timothyjager/JBC-Soldering-Controller/README.md

# JBC-Soldering-Controller
A DIY soldering controller for JBC T245 handle &amp; C245 tips
