timothyjager/JBC-Soldering-Controller/Hardware/MainBoard/MainBoard.PcbDoc.htm

Reporting Options

# File in Previous Format

Date | : | 6/10/2017
Time | : | 3:25:28 PM
Filename | : | C:\Users\timj\Documents\Arduino\JBC-Soldering-Controller\Hardware\MainBoard\MainBoard.PcbDoc

Version | Warning

This file was generated by an earlier version of the software
