timothyjager/JBC-Soldering-Controller/Hardware/Documents/MP2456.jpg

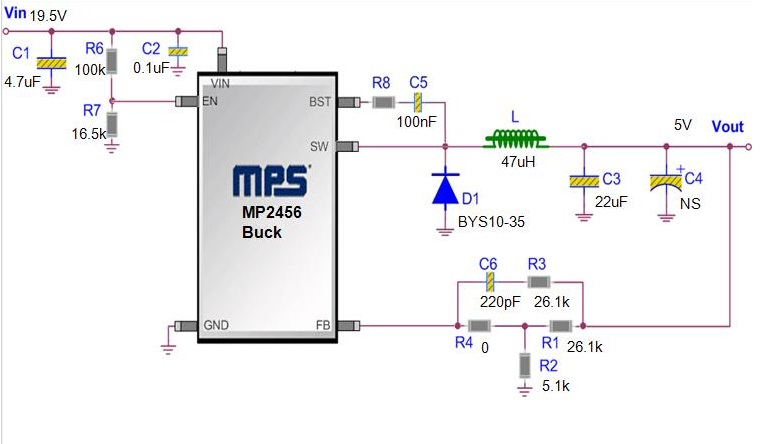
Hardware/Documents/MP2456.jpg
