timothyjager/JBC-Soldering-Controller/Hardware/Documents/MCP16301 Design Analyzer v1.0.xlsx

12
MCP16301 DESIGN ANALYZER
System Parameters | Designator |  | Units | Notes
Input Voltage | E | 24.0 | V | 3.0V < E < 30.0V
Output Voltage | U | 5.5 | V | 2.0V < U < 15.0V
Output Current | Io | 100 | mA | 0mA < Io < 600mA
Ambient Temperature | Ta | 25 | deg C | -40 < Ta < 125
 |  | Suggested Values |  | Adjustable Values
System Components | Designator |  | Units |  | Units
Minimum Required Inductance | Lmin | 17.9 | mH | 17.9 | mH
Inductance | L | 27 | mH | 27 | mH
Inductor DCR | Lr | 160 | mW | 160 | mW
Output Capacitor | C | 20 | mF | 20 | mF
Output Capacitor ESR | Cr | 5 | mW | 5 | mW
Catch Diode Forward Drop | Ufd | 0.240 | V | 0.240 | V
Compensation Components
Top Feedback Resistor | R11 | 107.0 | kW | 107.0 | kW
Bottom Feedback Resistor | R12 | 18.2 | kW | 18.2 | kW
External Zero Capacitor | C11 | 0 | pF | 0 | pF
Unity Gain Crossover Frequency |  | 21000 | Hz | 21000 | Hz
Phase Margin |  | 67.5 | Degrees | 67.5 | Degrees
