timothyjager/JBC-Soldering-Controller/Hardware/3DModels/VN50.SLDASM

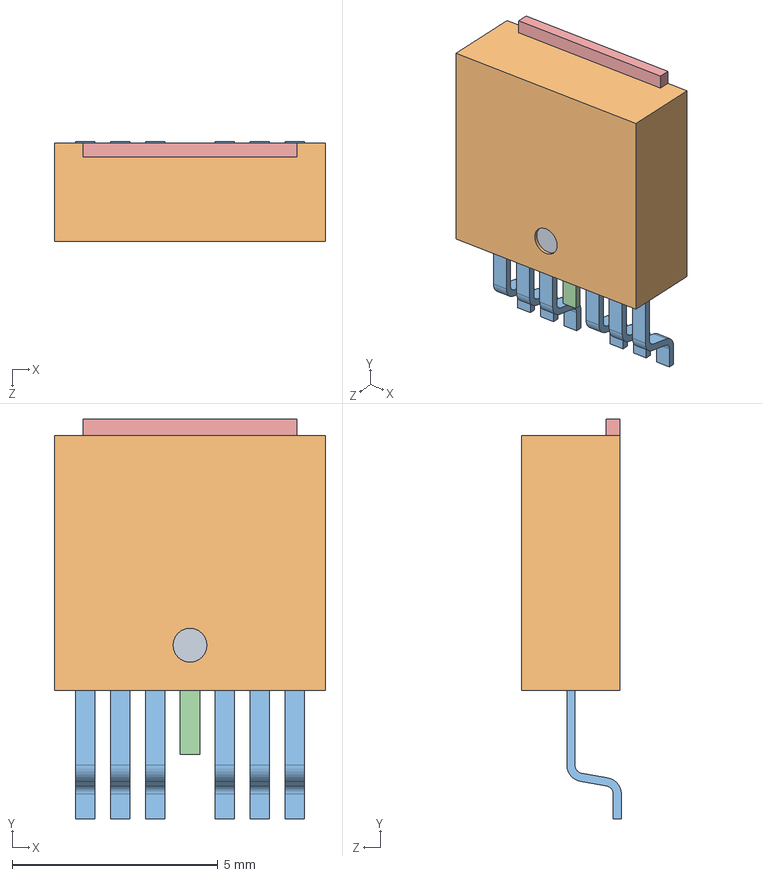
[picture p2: CAD file, 2018-01-24]
Hardware/3DModels/VN50.SLDASM
6.60 x 9.73 x 2.43 mm
Open_CASCADE_STEP_translator_6.8_5.1
Open_CASCADE_STEP_translator_6.8_5.2.1
Lead x 6
Trimmed_Lead
tab
