timothyjager/JBC-Soldering-Controller/Hardware/3DModels/ARDUINO PRO MICRO.SLDASM

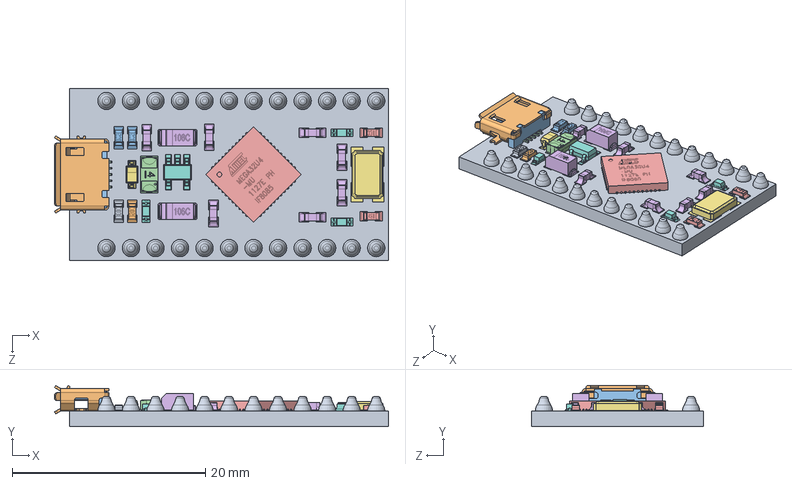
[picture p3: CAD file, 2018-01-24]
Hardware/3DModels/ARDUINO PRO MICRO.SLDASM
34.6 x 4.25 x 17.8 mm
micro board
micro usb shell
micro usb internal
micro usb contact x 5
atmega32U4
MICRO_cap106C x 2
micro_crystal 5x3
micro_MIC5219
MICRO_603 resistor 103
MICRO_603 resistor 102
MICRO_603 resistor 22 x 2
MICRO_PTC-1206
MICRO_603 resistor 331 x 2
MICRO_603 cap on pad x 7
SOD 323
MICRO_led x 3
