timothyjager/JBC-Soldering-Controller/Hardware/3DModels/SolderingController.SLDASM

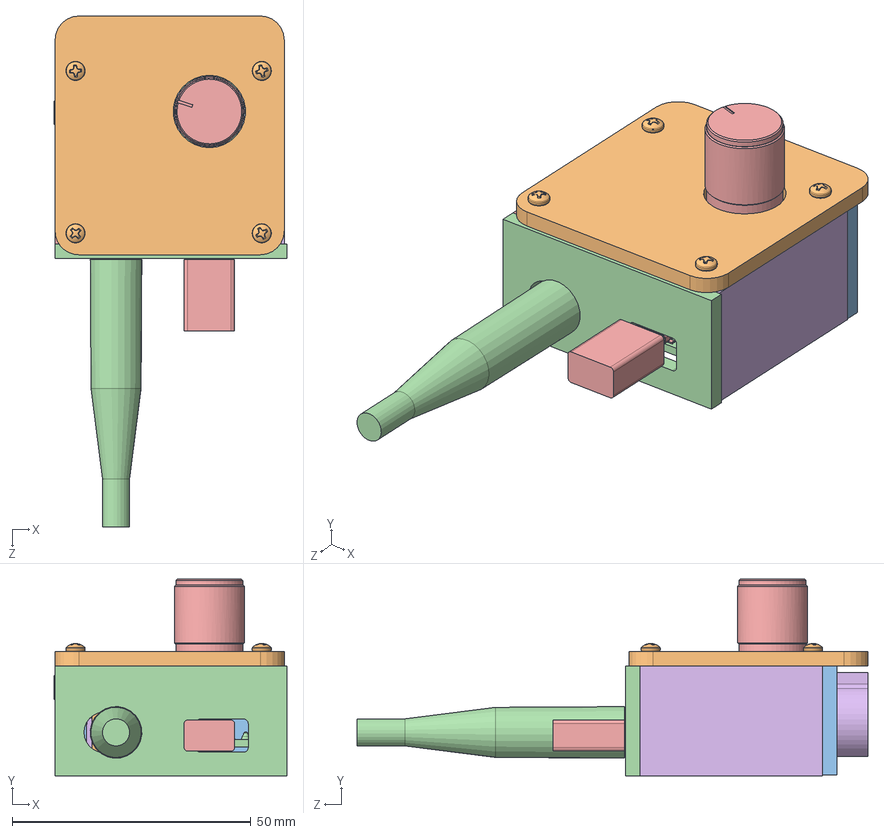
[picture p4: CAD file, 2018-01-24]
Hardware/3DModels/SolderingController.SLDASM
48.8 x 41.2 x 107.0 mm
PCB
DELL_A831M
OLED_0.91_128x32
micro board
micro usb shell
micro usb internal
micro usb contact x 5
atmega32U4
MICRO_cap106C x 2
micro_crystal 5x3
micro_MIC5219
MICRO_603 resistor 103
MICRO_603 resistor 102
MICRO_603 resistor 22 x 2
MICRO_PTC-1206
MICRO_603 resistor 331 x 2
MICRO_603 cap on pad x 7
SOD 323
MICRO_led x 3
pec11r-4x15k-sxxxx
KNOB_6mmShaft
Hirose-RPC1
OLEDFootprint
ProMicroFootprint
Open_CASCADE_STEP_translator_6.8_5.1
Open_CASCADE_STEP_translator_6.8_5.2.1
Lead x 6
Trimmed_Lead
tab
PowerPlug
MicroUSB
M2x12mmBrassStandoff x 4
M2x3x7mmBrassStandoff x 4
PJ-313D
WS2812b x 2
M2_Screw x 4
