timothyjager/JBC-Soldering-Controller/Hardware/3DModels/PowerConnector/Hirose-RPC1.SLDPRT

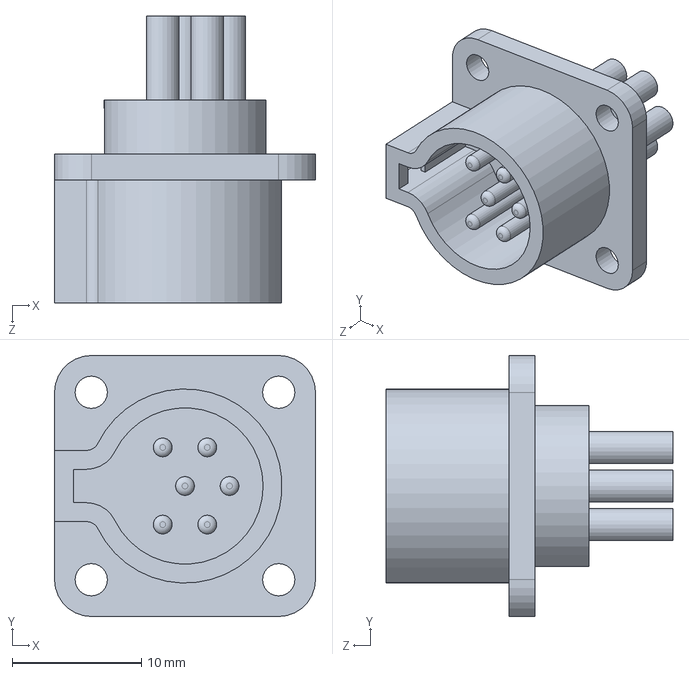
[picture p5: CAD file, 2018-01-24]
Hardware/3DModels/PowerConnector/Hirose-RPC1.SLDPRT
20.2 x 20.2 x 22.2 mm
