timothyjager/JBC-Soldering-Controller/Hardware/3DModels/PowerConnector/DELL_A831M.STEP

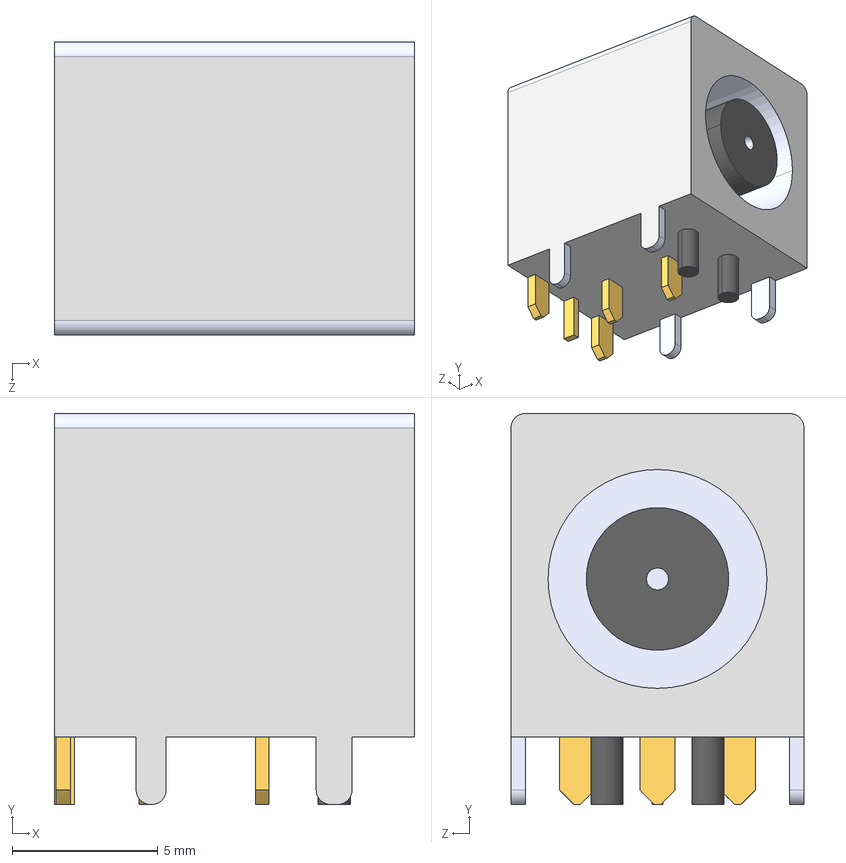
[picture p6: CAD file, 2018-01-24]
Hardware/3DModels/PowerConnector/DELL_A831M.STEP
12.3 x 13.4 x 10.1 mm
