timothyjager/JBC-Soldering-Controller/Hardware/3DModels/Encoder_with_knob.STEP

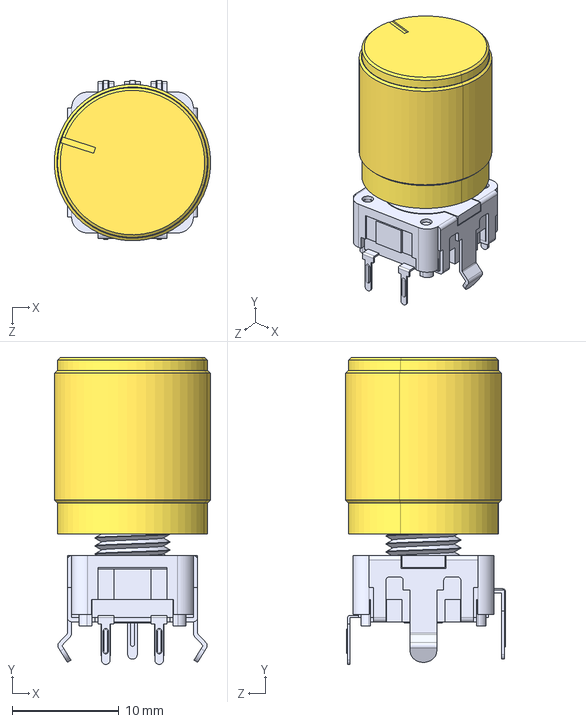
[picture p7: CAD file, 2018-01-24]
Hardware/3DModels/Encoder_with_knob.STEP
14.6 x 28.7 x 15.0 mm
pec11r-4x15k-sxxxx
KNOB_6mmShaft
