timothyjager/JBC-Soldering-Controller/Hardware/3DModels/PowerConnector/PWR.SLDPRT

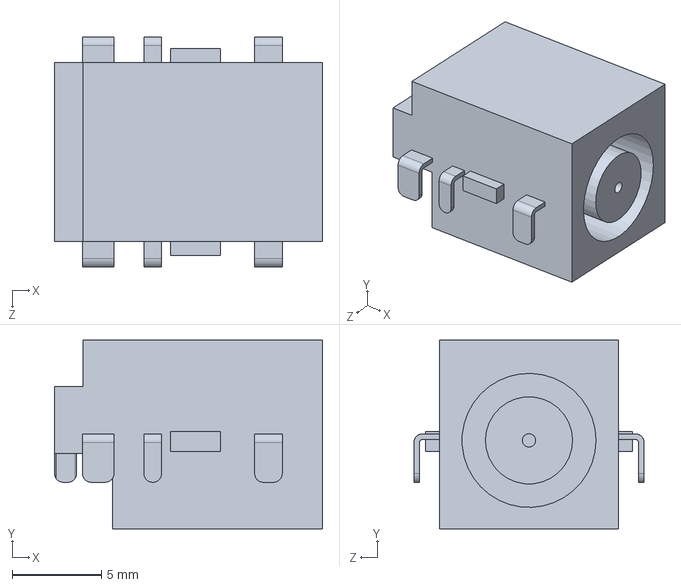
[picture p8: CAD file, 2018-01-24]
Hardware/3DModels/PowerConnector/PWR.SLDPRT
15.0 x 10.6 x 12.9 mm
