timothyjager/JBC-Soldering-Controller/Hardware/3DModels/M2.5X12mmStandoff.SLDPRT

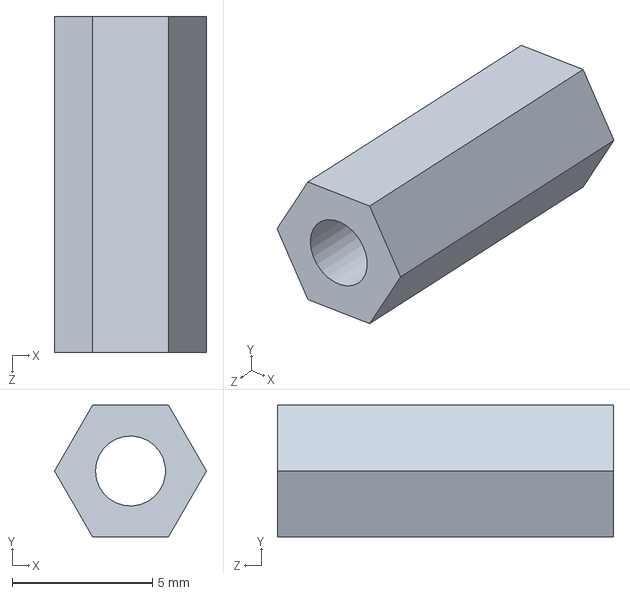
[picture p9: CAD file, 2018-01-24]
Hardware/3DModels/M2.5X12mmStandoff.SLDPRT
5.43 x 4.70 x 12.0 mm
