timothyjager/JBC-Soldering-Controller/Hardware/3DModels/Arduino Pro Micro Sparkfun.stp

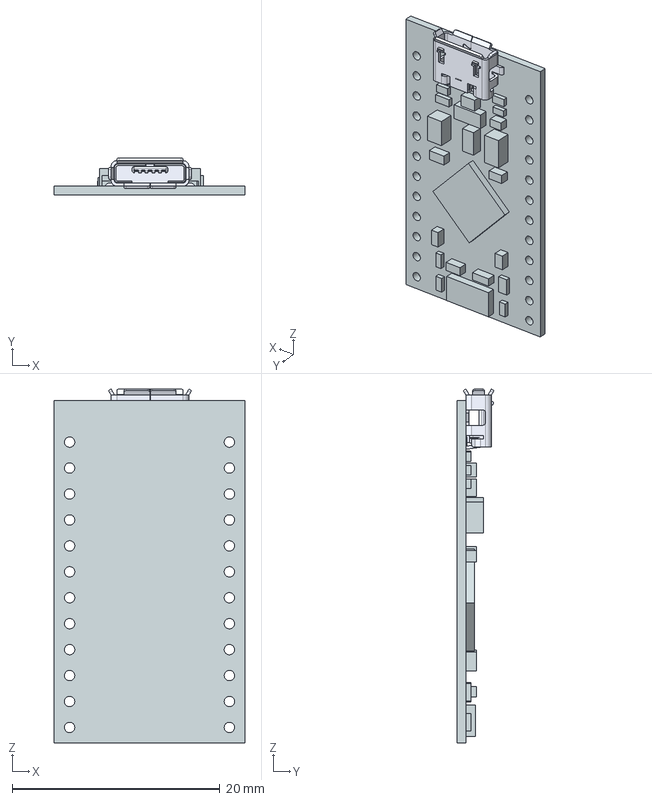
[picture p10: CAD file, 2018-01-24]
Hardware/3DModels/Arduino Pro Micro Sparkfun.stp
18.4 x 3.58 x 34.1 mm
