timothyjager/JBC-Soldering-Controller/Hardware/3DModels/CaseFront.SLDPRT

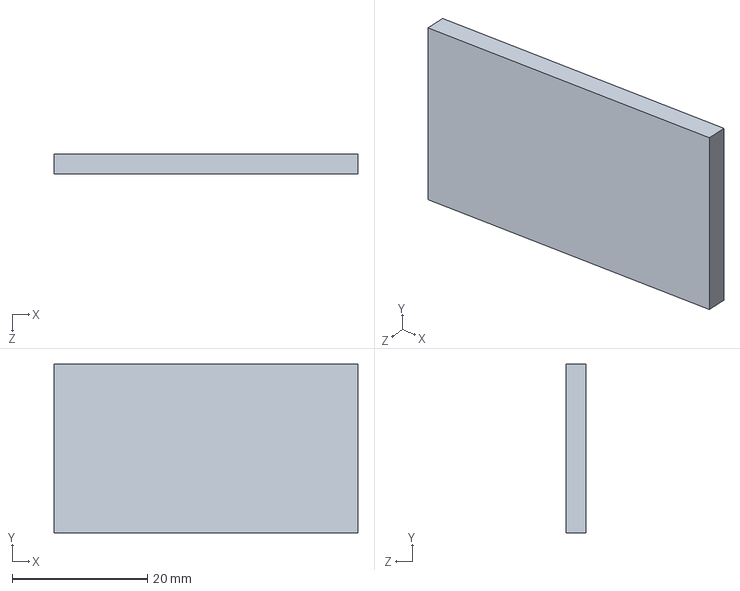
[picture p11: CAD file, 2018-01-24]
Hardware/3DModels/CaseFront.SLDPRT
45.0 x 25.0 x 3.00 mm
