timothyjager/JBC-Soldering-Controller/Hardware/3DModels/OLEDFootprint.SLDPRT

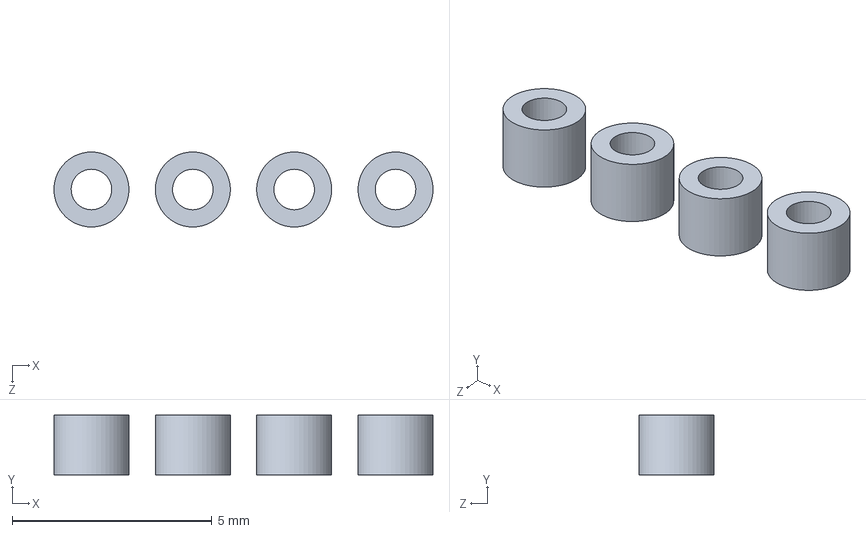
[picture p12: CAD file, 2018-01-24]
Hardware/3DModels/OLEDFootprint.SLDPRT
9.50 x 1.50 x 1.88 mm
