timothyjager/JBC-Soldering-Controller/Hardware/3DModels/KNOB_6mmShaft.SLDPRT

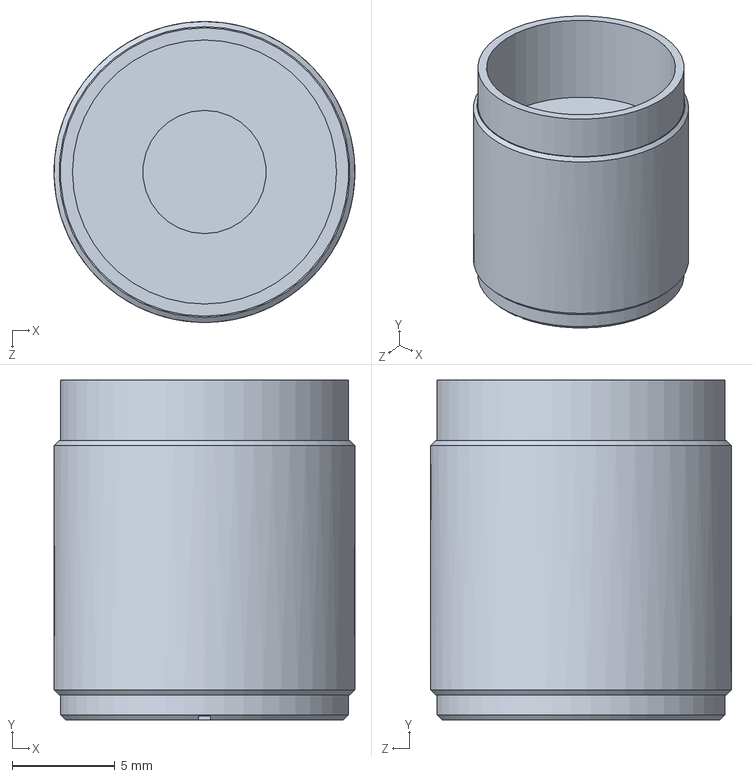
[picture p13: CAD file, 2018-01-24]
Hardware/3DModels/KNOB_6mmShaft.SLDPRT
14.6 x 16.6 x 14.7 mm
