timothyjager/JBC-Soldering-Controller/Hardware/3DModels/pec11r-4x15k-sxxxx.stp

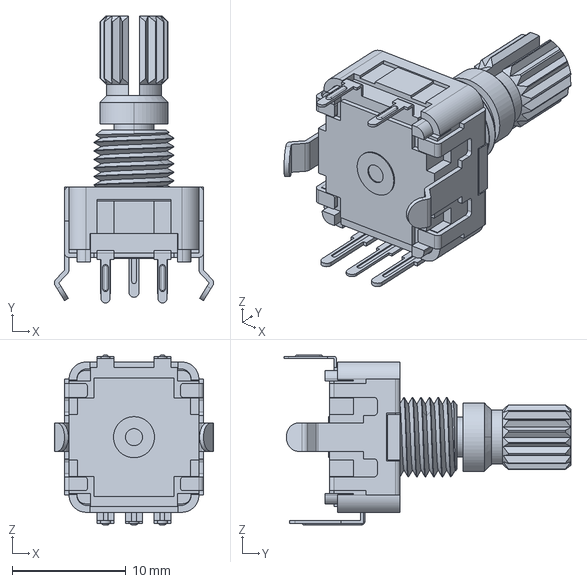
[picture p14: CAD file, 2018-01-24]
Hardware/3DModels/pec11r-4x15k-sxxxx.stp
14.0 x 25.2 x 14.9 mm
