timothyjager/JBC-Soldering-Controller/Hardware/3DModels/CaseTop.SLDPRT

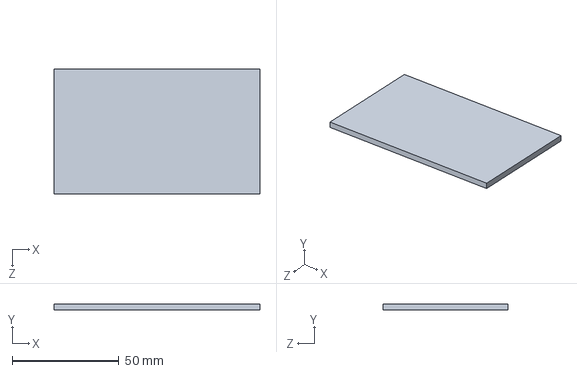
[picture p15: CAD file, 2018-01-24]
Hardware/3DModels/CaseTop.SLDPRT
96.7 x 3.00 x 58.8 mm
