timothyjager/JBC-Soldering-Controller/Hardware/3DModels/SRN5040 series.stp

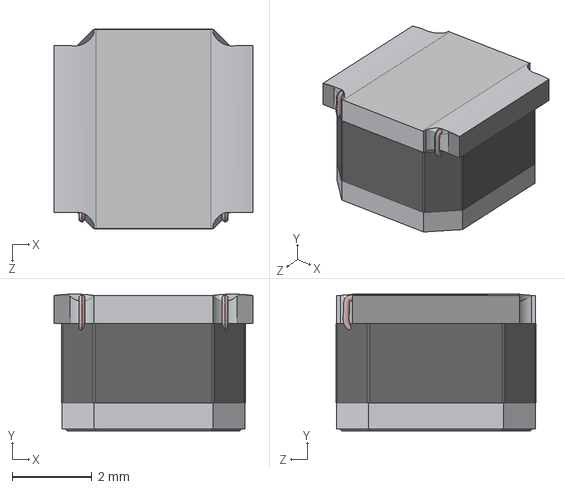
[picture p16: CAD file, 2018-01-24]
Hardware/3DModels/SRN5040 series.stp
5.00 x 3.44 x 5.02 mm
