timothyjager/JBC-Soldering-Controller/Hardware/3DModels/PJ-313D.STEP

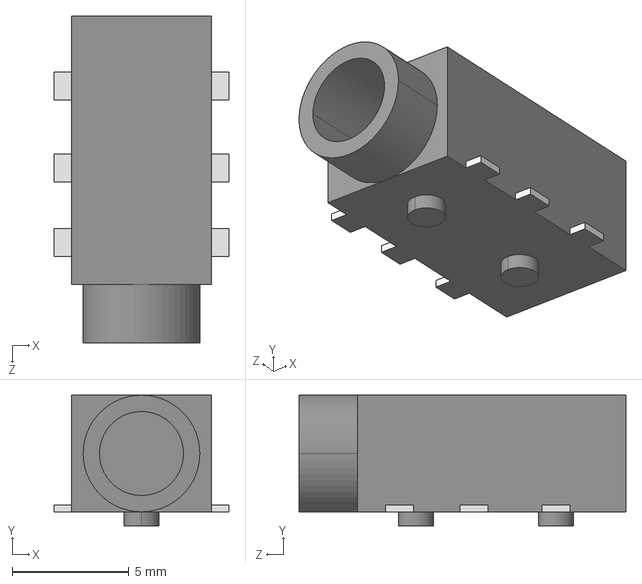
[picture p17: CAD file, 2018-01-24]
Hardware/3DModels/PJ-313D.STEP
7.50 x 5.60 x 14.0 mm
