timothyjager/JBC-Soldering-Controller/Hardware/3DModels/ProMicroFootprint.SLDPRT

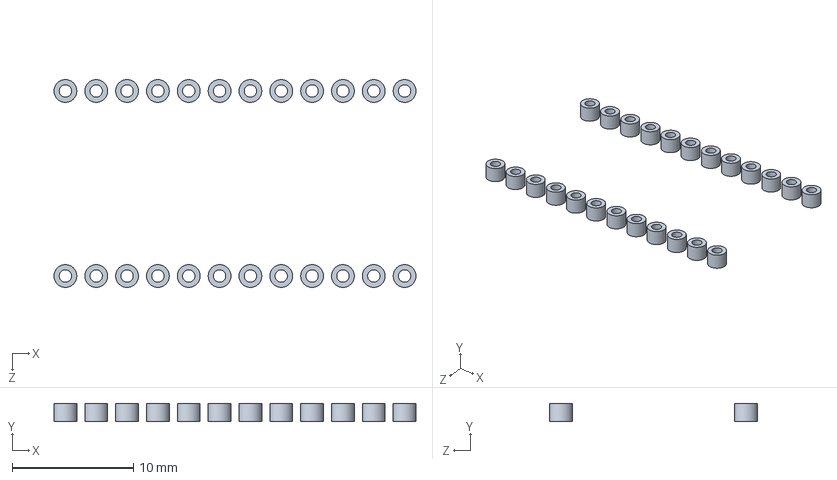
[picture p18: CAD file, 2018-01-24]
Hardware/3DModels/ProMicroFootprint.SLDPRT
29.8 x 1.50 x 17.1 mm
