timothyjager/JBC-Soldering-Controller/Hardware/3DModels/WS2812b.sldprt

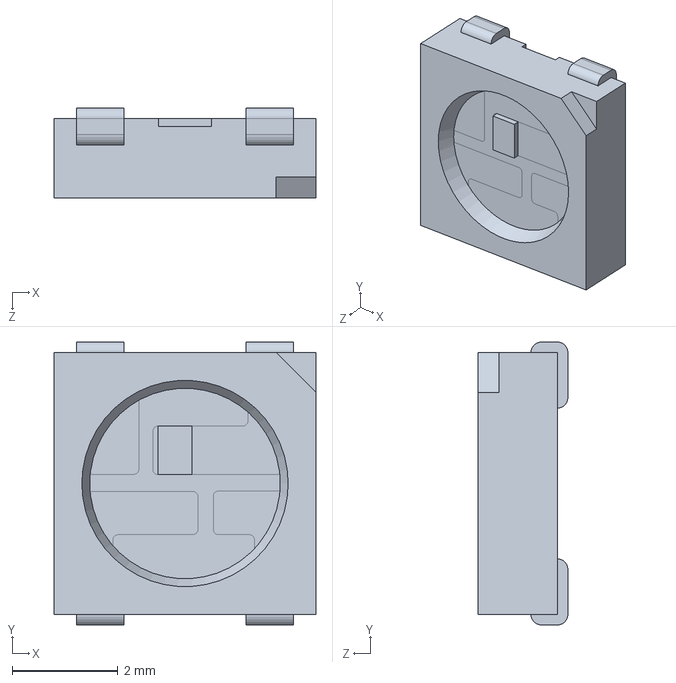
[picture p20: CAD file, 2018-01-24]
Hardware/3DModels/WS2812b.sldprt
4.95 x 5.35 x 1.70 mm
