timothyjager/JBC-Soldering-Controller/Hardware/3DModels/sj-2523-smt.SLDPRT

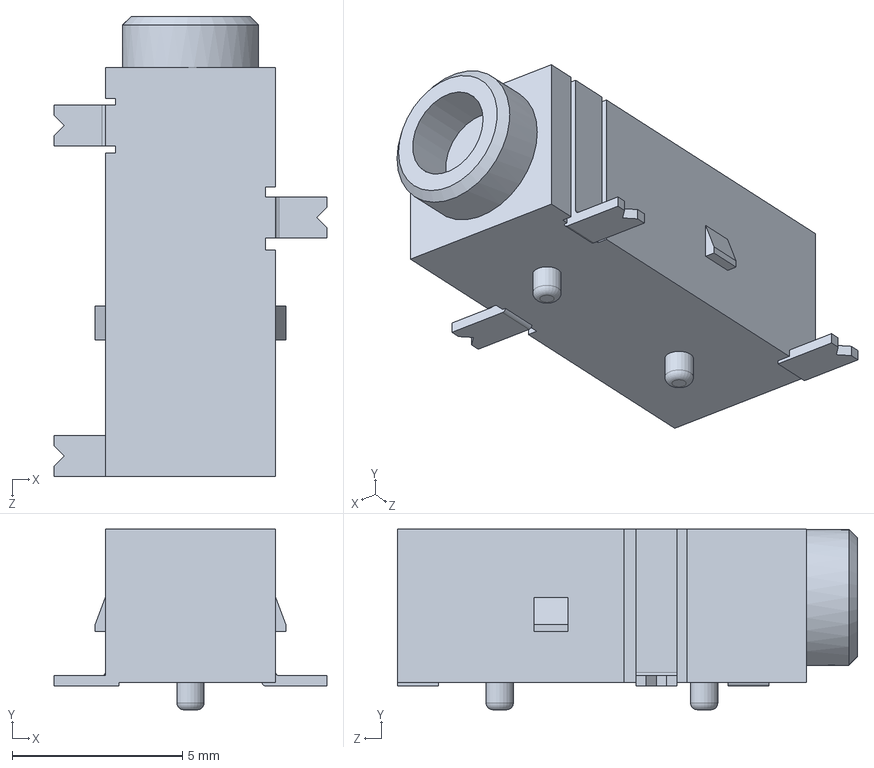
[picture p21: CAD file, 2018-01-24]
Hardware/3DModels/sj-2523-smt.SLDPRT
8.00 x 5.30 x 13.5 mm
