timothyjager/JBC-Soldering-Controller/Hardware/3DModels/PCB.STEP

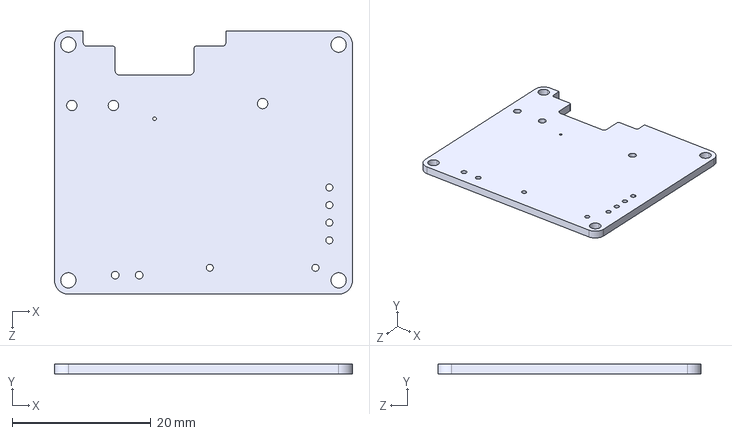
[picture p22: CAD file, 2018-01-24]
Hardware/3DModels/PCB.STEP
43.0 x 1.50 x 38.0 mm
