timothyjager/JBC-Soldering-Controller/(list of files, cad)

Other CAD files:
Hardware/3DModels/Assem4.SLDASM
Hardware/3DModels/Body.sldasm
Hardware/3DModels/Assem2.SLDASM
Hardware/3DModels/micro usb.sldasm
Hardware/3DModels/atmega32U4.sldprt
Hardware/3DModels/tab.sldprt
Hardware/3DModels/PowerConnector/dell_jack.STEP
Hardware/3DModels/MICRO_PTC-1206.sldprt
Hardware/3DModels/Lead.sldprt
Hardware/3DModels/Trimmed_Lead.sldprt
Hardware/3DModels/micro_MIC5219.sldprt
Hardware/3DModels/Open_CASCADE_STEP_translator_6.8_5.2.1.sldprt
Hardware/3DModels/PowerPlug.sldprt
Hardware/3DModels/micro board.sldprt
Hardware/3DModels/MICRO_603 resistor 22.sldprt
Hardware/3DModels/micro usb shell.sldprt
Hardware/3DModels/micro usb internal.sldprt
Hardware/3DModels/Open_CASCADE_STEP_translator_6.8_5.1.sldprt
Hardware/3DModels/micro usb contact.sldprt
Hardware/3DModels/Part4.sldprt
Hardware/3DModels/Board.sldprt
Hardware/3DModels/Part5.sldprt
Hardware/3DModels/CaseRight.sldprt
Hardware/3DModels/SOD 323.sldprt
Hardware/3DModels/MICRO_603 resistor 102.sldprt
Hardware/3DModels/SideLeft.sldprt
Hardware/3DModels/MICRO_603 resistor 331.sldprt
Hardware/3DModels/MICRO_led.sldprt
Hardware/3DModels/MICRO_cap106C.sldprt
Hardware/3DModels/micro_crystal 5x3.sldprt
Hardware/3DModels/MICRO_603 resistor 103.sldprt
Hardware/3DModels/Hirose-RPC1.STEP
Hardware/3DModels/MICRO_603 cap on pad.sldprt
Hardware/3DModels/Encoder_with_knob.SLDASM
Hardware/3DModels/M2x12mmBrassStandoff.SLDPRT
Hardware/3DModels/M2x3x7mmBrassStandoff.SLDPRT
Hardware/3DModels/MicroUSB.sldprt
Hardware/3DModels/OLED_0.91_128x32.SLDPRT
Hardware/3DModels/PCB.SLDPRT
Hardware/3DModels/PJ-313D.SLDPRT
Hardware/3DModels/PowerConnector/DELL_A831M.SLDPRT
Hardware/3DModels/pec11r-4x15k-sxxxx.SLDPRT
