timothyjager/JBC-Soldering-Controller/Firmware/JBC-Soldering-Controller/calculations.xlsx

Sheet: Sheet1
Vout | 19.5
R | 2.2
Iout | 8.863636364 | A
ratio | 7000
Isense | 0.001266233766 | A
Rsense | 2200 | ohm
Vsense | 2.785714286 | V

Sheet: Sheet2
ADC | deg C
220 | 60.5
250 | 72
520 | 143
780 | 228
1030 | 300
1283 | 370
1551 | 450
