timothyjager/JBC-Soldering-Controller/(threads)

Thread 4 (2018-12-01):

HT420-A Tweezers support

nikifena, 2018-12-01:
Hi there. My name is Niki. I'm PCB and 3D designer and I have been making many /mostly analog/ projects for over 15 years.
I checked your project. It looks good. I think to modify it a little bit the board since the tracks going to the pads has no teardrops and it's better to have ticker wires around the pads.

Anyway, I have JBC TH420-A soldering tweezers and I think it's good for having an optional way to power similar tweezers.
There is already one free thermocouple input - the spare input of ADS1118. So the only one extra hardware modification will be one wire for the current sense for another VN5E010AH. Both drivers can share the same PWM.

I can modify the PCB with all new improvements but I can't modify the code. I'm a PCB designer.

What do you think about that?

Another "Extra" modification could be two inputs - one for JBC iron and another for iron/tweezers.

Thanks and waiting for your answer.

Niki

PaulusSmallus, 2018-12-01:
If you have a look at the branch I made, there is code for tweezers. I designed it for PA120 tweezers, not 420. I have a feeling the maximum voltage is higher on the 420, so it would be worth checking it will work.
In any case, the code is there if you want it.
p.s. my PCB design is not great. my plan is do redo it.
https://github.com/PaulusSmallus/JBC-Soldering-Controller

liuweisword, 2018-12-19:
I want do it to
can we do it together？
wei.liu@cecooleye.cn

nikifena, 2018-12-19:
Thanks for the update!
I started with the PCB design but I'm busy with some other projects. I hope I will be ready until the end of this year.

PaulusSmallus, 2018-12-19:
Hello liu wei,
I am sure there is something you can help with. What are you good at?

liuweisword, 2018-12-21:
I am a  chinese, everything the project need is so easy and cheap to get .
I redesign your sch by orcad.    Meger the  arduino  in the main board .
I have a  team with my friend include the software and hareware ,structure .

Can we design a product with comparable or even better performance than JBC?

PaulusSmallus, 2019-01-09:
According to [this licence](https://github.com/timothyjager/JBC-Soldering-Controller/blob/master/LICENSE), you can use this for commercial purposes as long as you include the same licence agreement.

Thread 5 (2018-12-01):

contact

nikifena, 2018-12-01:
How can I contact you via email?

Can you send me a mail somehow? I'm not fimilar with github.

Thanks.
Niki

timothyjager, 2018-12-02:
Hi Niki,

nikifena, 2018-12-02:
No problem, but I prefer to mail or FB... or whatever.

Anyway. I will modify my idea for the SCH and I will try to send it here.

Thanks

timothyjager, 2018-12-02:
The original hardware designs were done in Altium Designer.  It looks like @PaulusSmallus made a fork of the project and used KiCad.

nikifena, 2018-12-02:
I have AD too and I like it and I use it. So I feel comfortable with it. I'm not fimilar with KiCad, but I can try it in the future.

timothyjager, 2018-12-02:
It sounds like you will want to fork my project so you can commit your changes to a new repo that you control.

PaulusSmallus, 2018-12-02:
If you look at [https://github.com/PaulusSmallus/JBC-Soldering-Controller/blob/master/Hardware/MainBoard/output/main.pdf](https://github.com/PaulusSmallus/JBC-Soldering-Controller/blob/master/Hardware/MainBoard/output/main.pdf)
you can see how I connected the extra channel up.

nikifena, 2018-12-03:
Yeah! something like that.
What do you think about adding another soldering iron?
this means another as1118 and VN5E010?

I can make the PCB design as I told you, but I'm not familiar with coding

PaulusSmallus, 2018-12-03:
The tweezers are essentially 2 soldering irons. So you would have a choice of 1 tweezer, or 2 normal soldering irons.
If you wanted more than that, I would use 2 processors. Driving from one uP might work, but it will not be worth the time.

liuweisword, 2018-12-21:
I would like to ask a question.

How to calibrate the temperature?

How to adapt to different soldering heads?

PaulusSmallus, 2018-12-21:
I calibrated the temperature using another thermocouple to measure the temperature of the iron. I then adjusted the code with the measurements.

Do you mean different tips (i.e. different shaped tips)? or different irons (i.e. trying to tell the difference between a PA120 and a T245)?

liuweisword, 2018-12-21:
I use this to calibrated the temperature.
https://item.taobao.com/item.htm?spm=a1z09.2.0.0.15122e8dS0BTdm&id=531410507111&_u=l1vnqbqda1a

but,when I change the different tips  the temperature need to  cali again.
some tips is big, some is small. so the temperature always need to calibrated.
Can  I   set a Auto Calibration function  for all the tips？

https://item.taobao.com/item.htm?spm=a1z09.2.0.0.75532e8dDVJaed&id=534571482676&_u=l1vnqbqa95b

PaulusSmallus, 2019-01-09:
Sorry for the late reply. I have been thinking about this.
What you linked to is the sort of thing I used to measure the temperature of the iron.

I don't know if this will work, but I think its worth a try (even if it is just for the fun of it).
The difference between the tip temperature and the thermocouple temperature is going to be proportional to the power going through the tip. Assuming that that this proportionality is roughly consistent between tips, you might be able to get a more accurate tip temperature by taking this error into account.
I hope that makes sense.

Thread 8 (2020-02-07):

Sketch size is 109%

mmanchev, 2020-02-07:
Hi, I want to implement this project. I've gone trough the sketch and all libraries, and it compiles successfully, but it's oversized. My board setup is Arduino Leonardo, which I found is the analog of the Pro Micro. This is the error message -
`arduino_build_334303/JBC-Soldering-Controller.ino.elf
Sketch uses 31454 bytes (109%) of program storage space. Maximum is 28672 bytes.

Global variables use 808 bytes (31%) of dynamic memory, leaving 1752 bytes for local variables. Maximum is 2560 bytes.
Sketch too big; see http://www.arduino.cc/en/Guide/Troubleshooting#size for tips on reducing it.
Error compiling for board Arduino Leonardo.`

Thread 9 (2023-07-19):

Temperature error during contact of the tips

Tomatendose, 2023-07-19:
Hello, I have the problem that although both tips are connected to the same GND, the tips affect each other when they touch. When the tips touch, one tip gets a negative or near zero temperature, the temperature seems to add up on the other tip. This causes the PID controller to heat one tip too high.

Can anyone reproduce this problem. Is it due to the ADS1118. I am using a PA120 tweezers. Have an attiny 3216 and matched the program.

Übersetzt mit DeepL (https://www.deepl.com/app/?utm_source=ios&utm_medium=app&utm_campaign=share-translation

PaulusSmallus, 2023-07-21:
That is a weird problem, I have not come across this before. I would double check the wiring is correct. Maybe the positive and negative of one of the heaters is the wrong way round? I shall have a think.

PaulusSmallus, 2023-08-22:
What settings do you use for the ADC? maybe the MUX is set wrong.

Tomatendose, 2023-08-23:
#define ADS1118_SINGLE_SHOT_INTERNAL_TEMPERATURE 0x859B
#define ADS1118_SINGLE_SHOT_ADC 0x8BEB
#define ADS1118_SINGLE_SHOT_ADC_2 0xBBEB
