timothyjager/JBC-Soldering-Controller/Hardware/JBC-Soldering-Controller_SCH_[No Variations].PDF

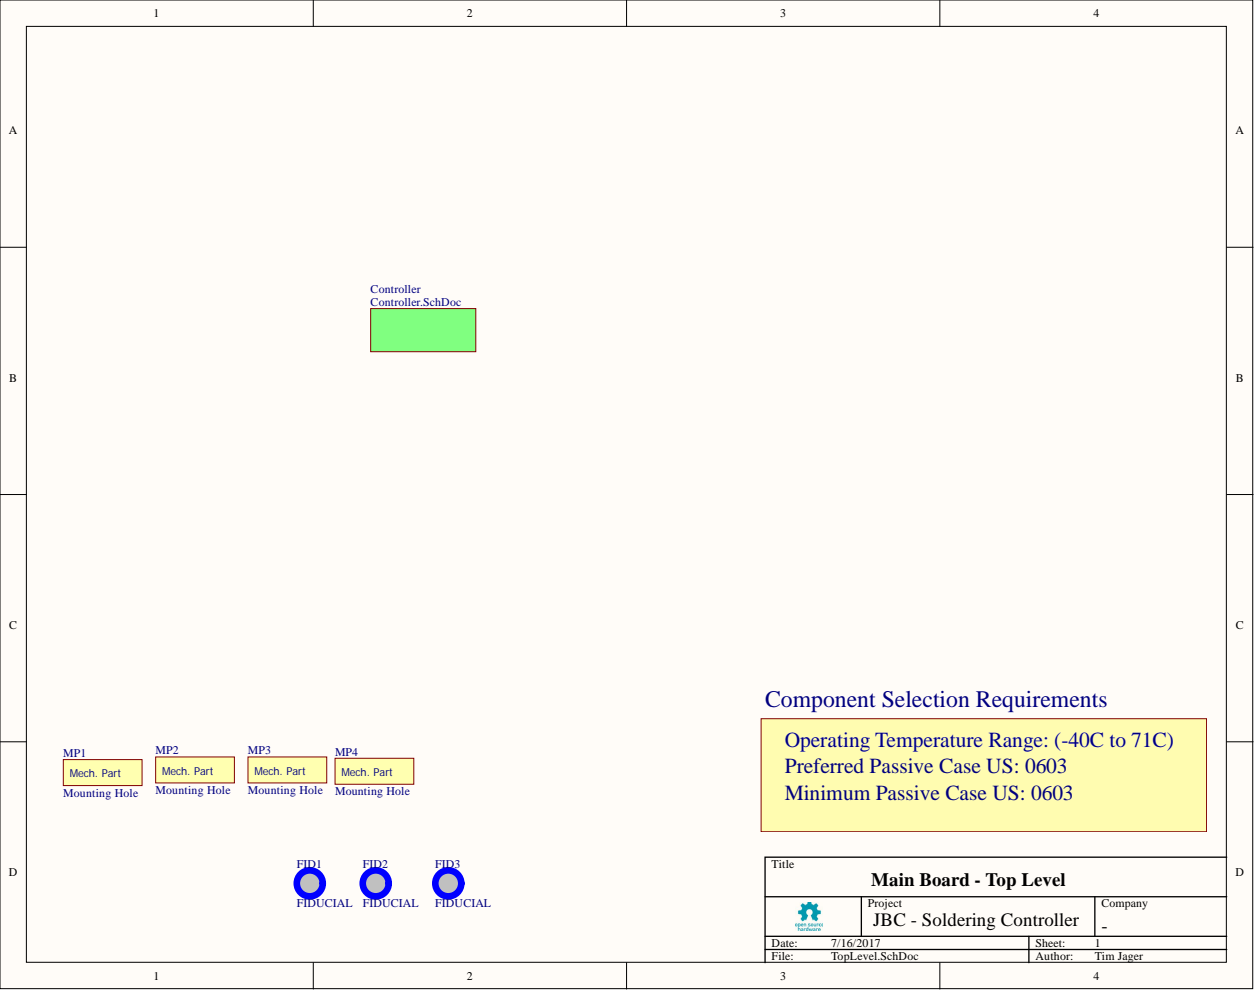
[picture p23: page 1]

Operating Temperature Range: (-40C to 71C)
Preferred Passive Case US: 0603
Minimum Passive Case US: 0603

Main Board - Top Level

Project JBC - Soldering Controller | Company -

Date: 7/16/2017 | Sheet: 1
File: TopLevel.SchDoc | Author: Tim Jager

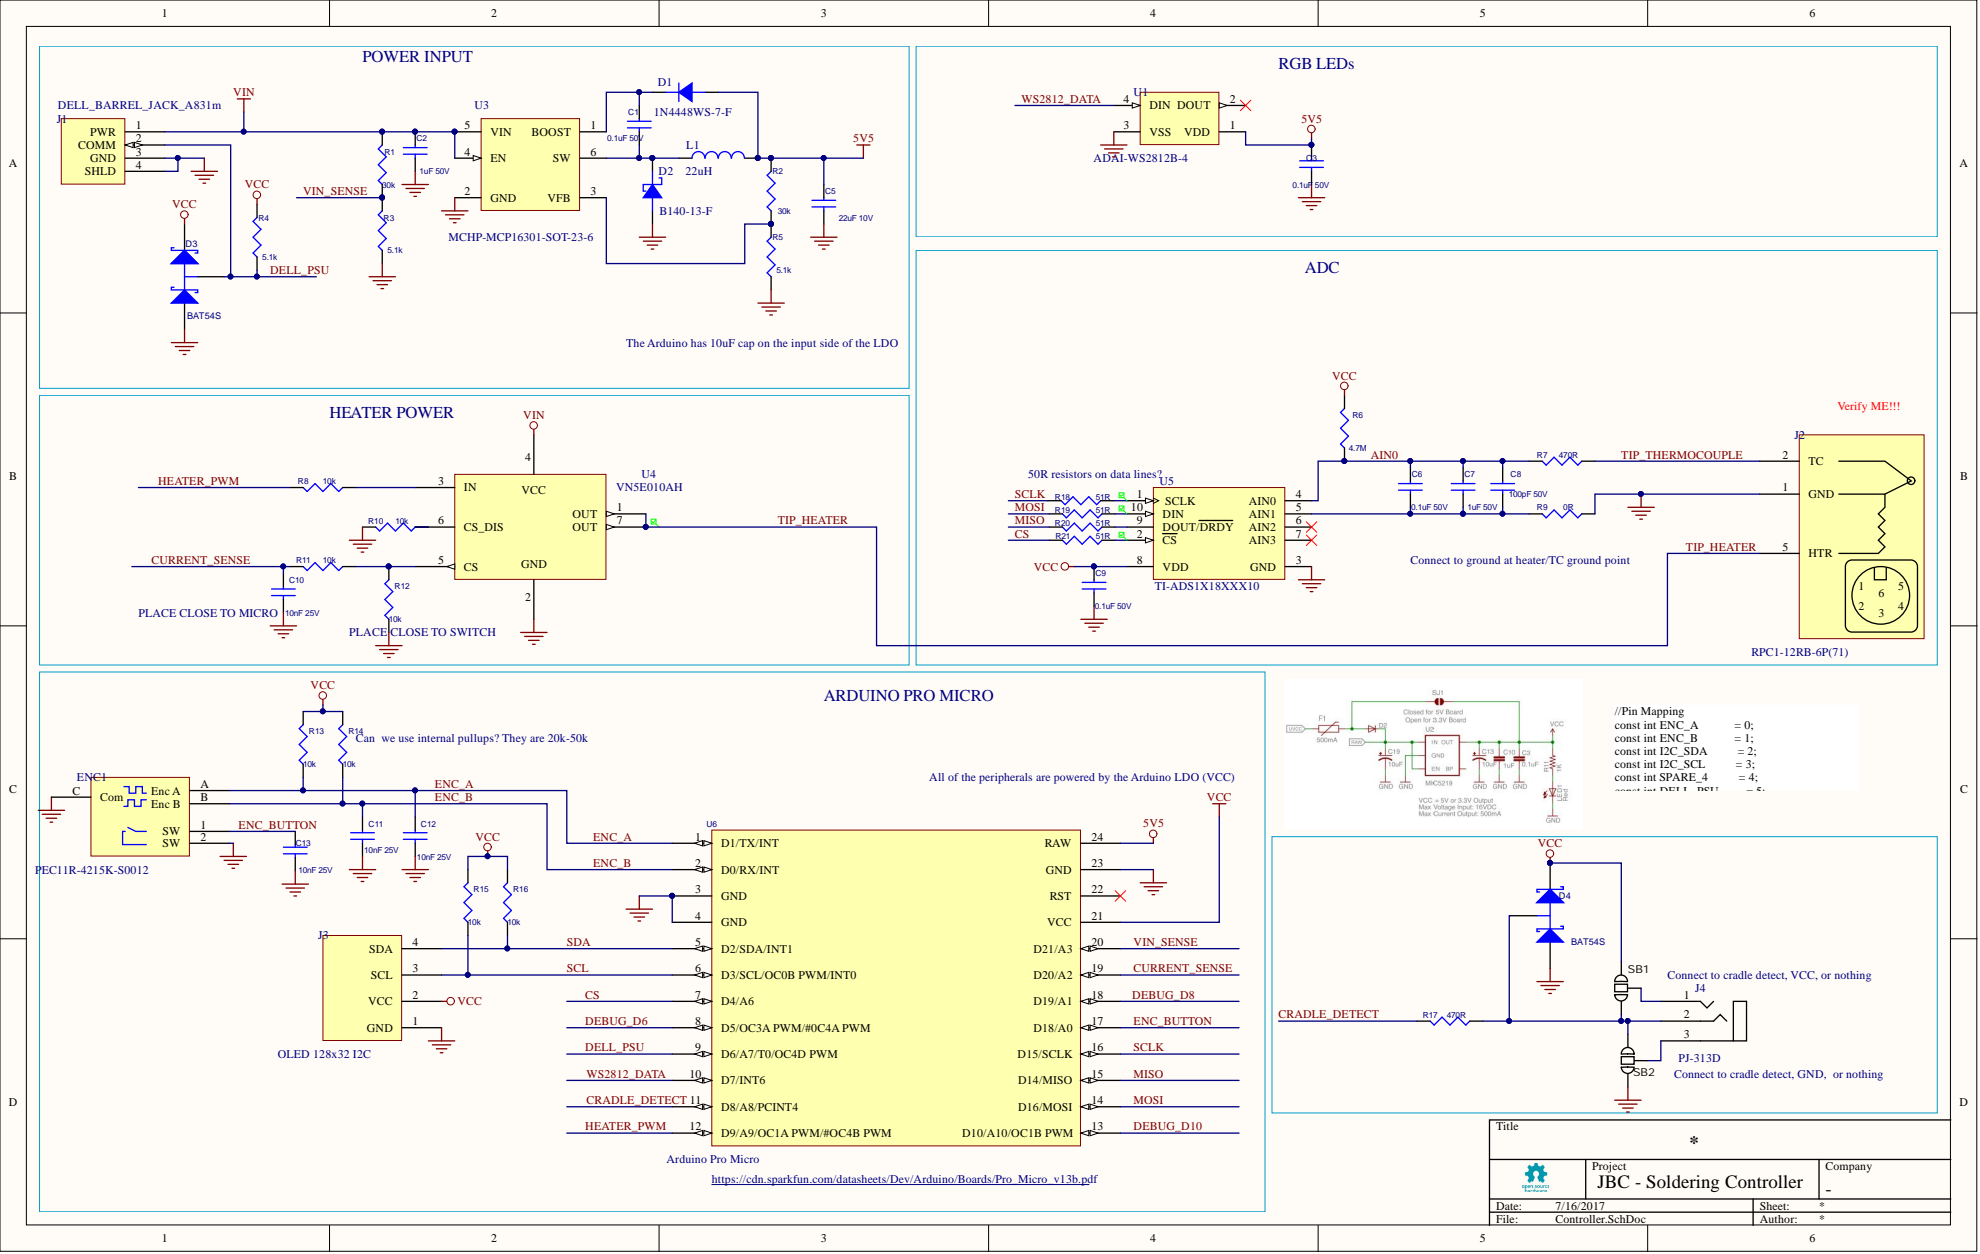
[picture p24: page 2]

POWER INPU T | RGB LED s

1 E NC_BU T T | VCC

o Pro Micro https://cdn.s

Project JBC - Solderin g Co ntroller | Compan y -

Date: 7 / 1 6 / 2 0 1 7 | Sheet : **
Fi le: Co n tro l ler.Sch D o c | A u t h or:
