timothyjager/JBC-Soldering-Controller/(list of files, drawings)

Other design files:
Hardware/MainBoard/Controller.SchDoc
Hardware/MainBoard/JBC-Soldering-Controller.PrjPCB
Hardware/MainBoard/Power2.SchDoc
Hardware/MainBoard/Power3.SchDoc
Hardware/MainBoard/Power.SchDoc
Hardware/MainBoard/TopLevel.SchDoc
Hardware/Shared Libraries/JBC-Soldering-Controller.SCHLIB
Hardware/Shared Libraries/SolderingController.PcbLib
Hardware/Shared Libraries/SolderingController.SchLib
