timothyjager/JBC-Soldering-Controller/(commit log)

2017-05-16 moved to new folder per arduino requirements
2017-05-16 pin mapping
2017-05-23 added initial PID controller
2017-05-23 stubbing out PID and calibration
2017-05-23 ads1118 ADC datasheet
2017-05-23 added call to pid.compute
2017-05-24 checkin after testing high side driver. Driver works, but messes up ADC reading.. need to debug.
2017-05-24 #define wasn't calculating correctly so i hard coded it for testing. now ADC reading works while the heater is on.
    [JBC-Soldering-Controller.ino]
2017-06-01 integrated serial comm to PC. Initial PID testing success. lots of test code. needs cleanup, and some refactoring.
2017-06-09 integrated encoder, tested PSU detect, misc temp code for testing.
2017-06-09 added datasheet for high side driver
2017-06-11 Initial Schematic Commit
    [Controller.SchDoc, JBC-Soldering-Controller.PrjPCB, MainBoard.PcbDoc, Power.SchDoc, Power2.SchDoc, SolderingController.PcbLib, SolderingController.SchLib, TopLevel.SchDoc]
2017-06-11 added OLED
    [Controller.SchDoc]
2017-06-12 schematic progress check-in.
    [Controller.SchDoc, JBC-Soldering-Controller.PrjPCB, Power.SchDoc, SolderingController.SchLib, TopLevel.SchDoc]
2017-06-13 replaced DC DC converter.
    [Controller.SchDoc, JBC-Soldering-Controller.PrjPCB, MCP16301 Design Analyzer v1.0.xlsx, Power.SchDoc, Power3.SchDoc]
2017-06-14 misc schematic cleanup & consolidation
    [Controller.SchDoc, JBC-Soldering-Controller.PrjPCB, MainBoard.PcbDoc, Power.SchDoc, TopLevel.SchDoc]
2017-06-16 added model for DELL power jack
    [PWR.SLDPRT, dell_jack.STEP]
2017-06-21 created dell power adapter footprint. though i may end up using a differnt part due to clearance issues.
    [Controller.SchDoc, JBC-Soldering-Controller.PrjPCB, MainBoard.PcbDoc, PWR.SLDPRT, SolderingController.PcbLib, SolderingController.SchLib]
2017-06-23 added model for alternate dell power connector
    [DELL_A831M.SLDPRT, DELL_A831M.STEP]
2017-06-24 added controller assembly
    [ARDUINO PRO MICRO.SLDASM, Arduino Pro Micro Sparkfun.stp, DELL_A831M.SLDPRT, Encoder_with_knob.SLDASM, Encoder_with_knob.STEP, Hirose-RPC1.SLDPRT, Hirose-RPC1.STEP, KNOB_6mmShaft.SLDPRT]
2017-06-25 Preliminary case concept
    [ARDUINO PRO MICRO.SLDASM, CaseFront.SLDPRT, CaseRight.sldprt, CaseTop.SLDPRT, DELL_A831M.SLDPRT, Encoder_with_knob.SLDASM, Hirose-RPC1.SLDPRT, KNOB_6mmShaft.SLDPRT]
2017-06-25 added power plug and USB plug to ensure proper fit
    [ARDUINO PRO MICRO.SLDASM, Assem2.SLDASM, Assem4.SLDASM, Board.sldprt, Body.sldasm, CaseFront.SLDPRT, CaseRight.sldprt, CaseTop.SLDPRT]
2017-06-26 added standoffs and 2.5mm jack
    [ARDUINO PRO MICRO.SLDASM, Assem2.SLDASM, Assem4.SLDASM, Body.sldasm, CaseFront.SLDPRT, CaseRight.sldprt, CaseTop.SLDPRT, DELL_A831M.SLDPRT]
2017-06-26 misc component updates
    [SolderingController.PcbLib, SolderingController.SchLib]
2017-06-29 added cradle detect
    [Controller.SchDoc, MainBoard.PcbDoc, TopLevel.SchDoc]
2017-06-29 added 2.5mm phono jack
    [SolderingController.PcbLib, SolderingController.SchLib]
2017-06-29 misc model updates
    [ARDUINO PRO MICRO.SLDASM, Body.sldasm, CaseFront.SLDPRT, CaseRight.sldprt, CaseTop.SLDPRT, DELL_A831M.SLDPRT, Encoder_with_knob.SLDASM, Hirose-RPC1.SLDPRT]
2017-06-29 step files
    [MainBoard.PcbDoc]
2017-06-30 misc updates to PCB and components
    [ARDUINO PRO MICRO.SLDASM, Body.sldasm, CaseFront.SLDPRT, CaseRight.sldprt, CaseTop.SLDPRT, Controller.SchDoc, DELL_A831M.SLDPRT, Encoder_with_knob.SLDASM]
2017-07-02 added screws, misc schematic improvements, removed warnings
    [ARDUINO PRO MICRO.SLDASM, Body.sldasm, CaseFront.SLDPRT, CaseRight.sldprt, CaseTop.SLDPRT, Controller.SchDoc, DELL_A831M.SLDPRT, Encoder_with_knob.SLDASM]
2017-07-03 ROUTING IN PROGRESS
    [Controller.SchDoc, SolderingController.PcbLib]
2017-07-07 moved 3.5mm jack pos. fixed all PCB DRC errors
    [ARDUINO PRO MICRO.SLDASM, Body.sldasm, CaseFront.SLDPRT, CaseRight.sldprt, CaseTop.SLDPRT, Controller.SchDoc, DELL_A831M.SLDPRT, Encoder_with_knob.SLDASM]
2017-07-10 misc routing cleanup
    [Controller.SchDoc, JBC-Soldering-Controller.PrjPCB]
2017-07-13 Misc project organization updates. Adding project params and sheet params
    [Controller.SchDoc, JBC-Soldering-Controller.PrjPCB, MCP16301 Design Analyzer v1.0.xlsx, TopLevel.SchDoc]
2017-07-17 v1.0 Release as submitted to PCB vendor
    [Controller.SchDoc, JBC-Soldering-Controller.PrjPCB, TopLevel.SchDoc]
2017-07-17 misc updates: rounded board corners, centering encoder, etc.
    [ARDUINO PRO MICRO.SLDASM, Body.sldasm, CaseFront.SLDPRT, CaseRight.sldprt, CaseTop.SLDPRT, DELL_A831M.SLDPRT, Encoder_with_knob.SLDASM, Hirose-RPC1.SLDPRT]
2017-08-12 updated BOM
    [Controller.SchDoc, JBC-Soldering-Controller.PrjPCB, TopLevel.SchDoc]
2018-01-20 Remapped IO to match final PCB. Tested peripherals. Heater, LED, Temperature, ADC, Voltage Sense, Cradle, etc.
2018-01-20 Misc. Schematic cleanup
    [Controller.SchDoc, JBC-Soldering-Controller.PrjPCB]
2018-01-20 Misc. Changes to support PID tuning application
2018-01-22 Refactored communication between arduino and labVIEW
2018-01-23 PID tuning. Some quick implementations of key functions to prepare for demo. Lots of refactoring is needed.
    [calculations.xlsx]
2018-01-23 fixed bug in display refresh logic.
    [_05_display.ino]
2018-01-26 added schematic
